XCthulhudj/BALANCE_CAR/Doc/PCB_View.pdf

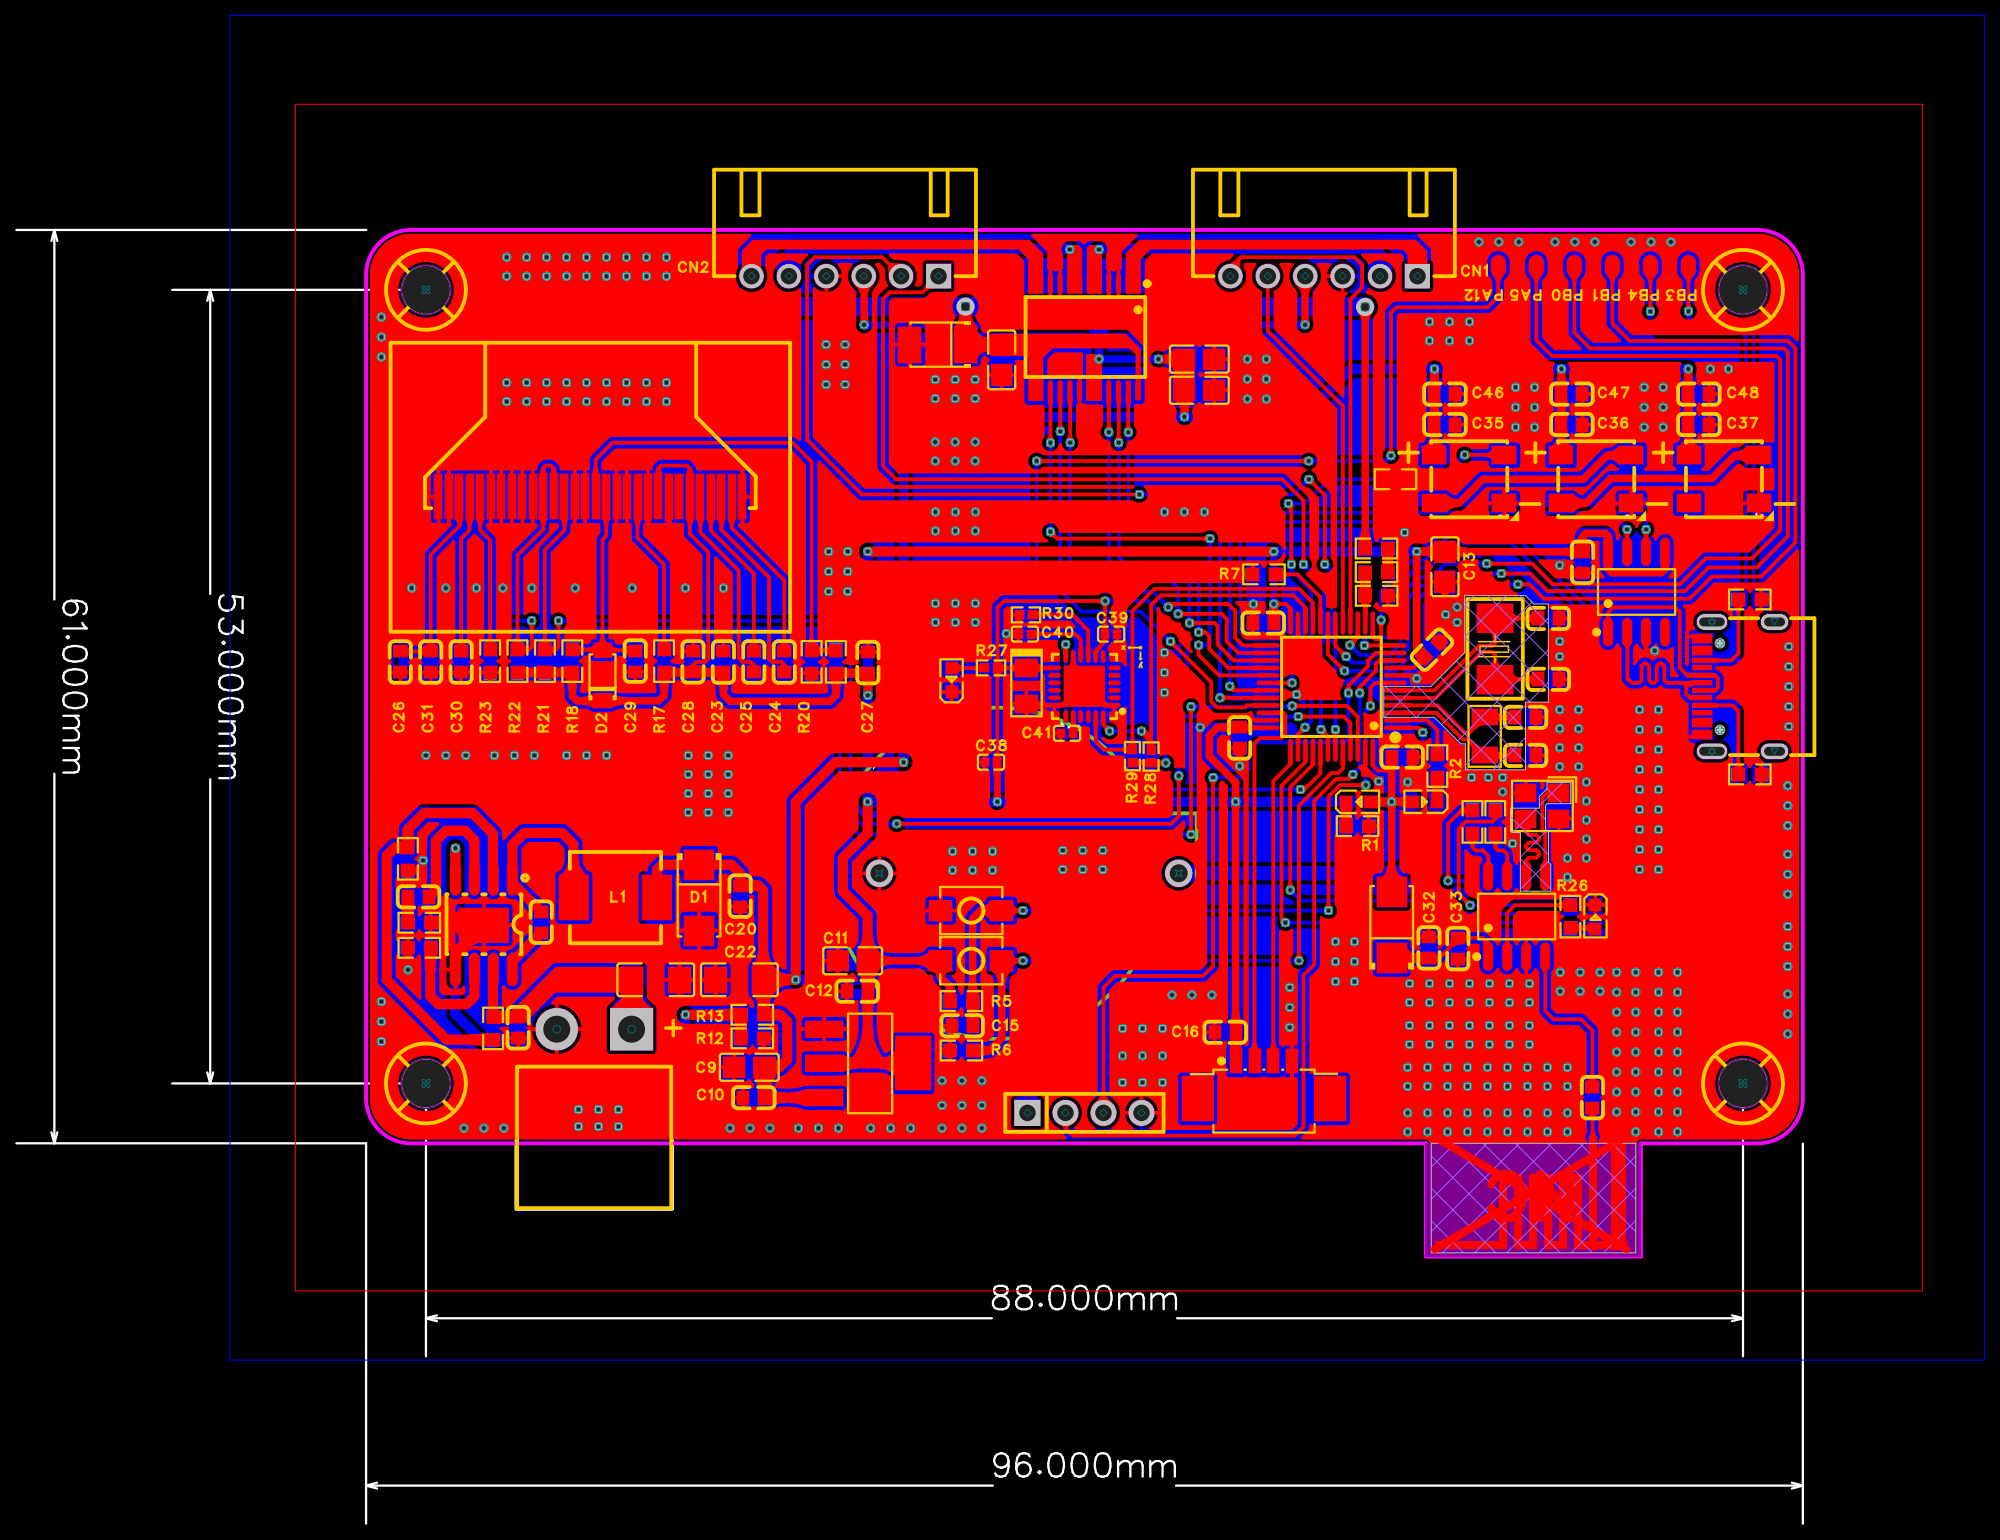
[picture p1: page 1]

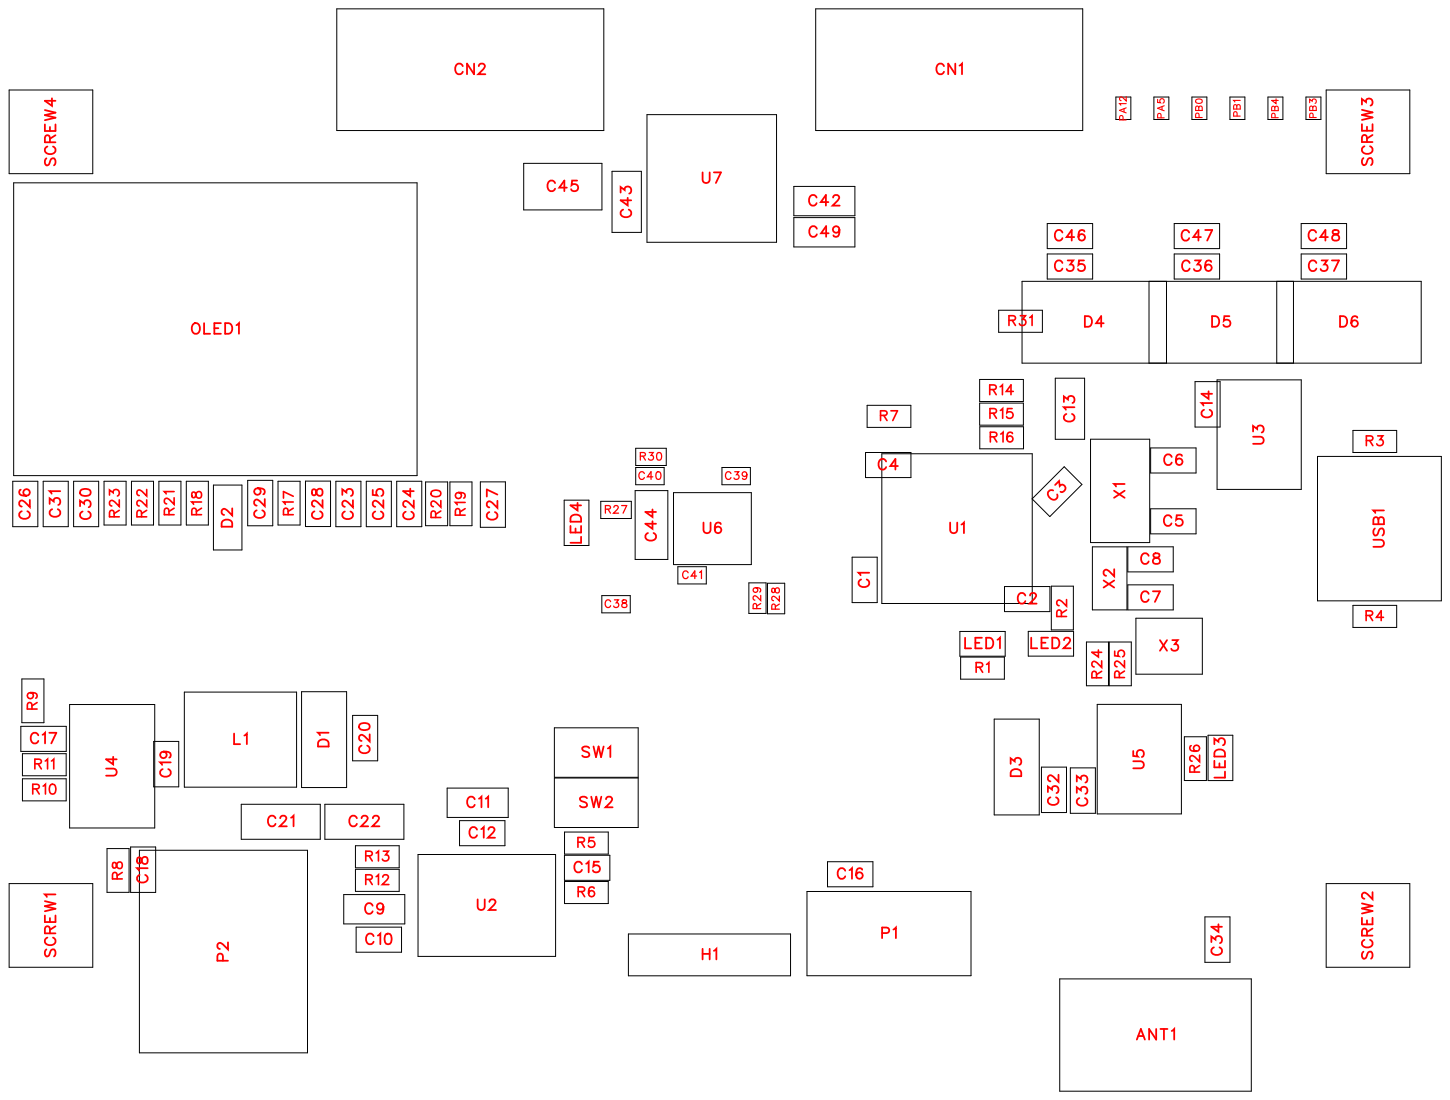
[picture p2: page 2]

BAT1

No. | Quantity | Comment | Designator | Footprint | Value | Manufacturer Part | Manufacturer | Supplier Part | Supplier
1 | 1 | KH-BS2032-2-1 | BAT1 | BAT-TH_KH-BS2032-2-1 | | KH-BS2032-2-1 | kinghelm(金 航标) | C3038670 | LCSC
2 | 16 | 100nF | C1,C2,C3,C4,C10,C12,C14, C15,C16,C18,C19,C20,C33 ,C35,C36,C37 | C0603 | 100nF
3 | 4 | 22pF | C5,C6,C7,C8 | C0603 | 22pF
4 | 4 | 10uF | C9,C11,C13,C49 | C0805 | 10uF
5 | 1 | 100pF | C17 | C0603 | 100pF
6 | 2 | 10uF | C21,C22 | C1206 | 10uF
7 | 5 | 1uF | C23,C24,C25,C26,C27 | C0603 | 1uF
8 | 4 | 2.2uF | C28,C29,C30,C31 | C0603 | 2.2uF
9 | 4 | 10uF | C32,C46,C47,C48 | C0603 | 10uF
10 | 1 | 2.7pF | C34 | C0603 | 2.7pF
11 | 1 | 10uF | C38 | C0402 | 10uF
12 | 1 | 10nF | C39 | C0402 | 10nF
13 | 1 | 100nF | C40 | C0402 | 100nF
14 | 1 | 2.2nF | C41 | C0402 | 2.2nF
15 | 2 | 100nF | C42,C43 | C0805 | 100nF
16 | 1 | 3216A-0.1uF/ 4V | C44 | CAP-SMD_L 3.2-W1.6-FD | | 3216A-0.1uF/ 4V | | C990000143 2 | LCSC
17 | 1 | 10uF | C45 | CASE-B_352 8 | 10uF | CA45-B-25V-10uF-K | CEC(振华新 云) | C128259 | LCSC
18 | 2 | X8821WR-06 S-N0SN | CN1,CN2 | CONN-TH_6 P-P2.50_X88 21WR-06S-N 2SN | | X8821WR-06 S-N0SN | XKB Connect ion(中国星坤) | C388743 | LCSC
19 | 1 | SS34 | D1 | SMA_L4.3-W 2.6-LS5.2-R D | | SS34 | MDD(辰达半 导体) | C8678 | LCSC
20 | 1 | 1N4148W-E3 -08 | D2 | SOD-123_L2 .8-W1.8-LS3. 7-RD | | 1N4148W-E3 -08 | VISHAY(威世 ) | C241939 | LCSC
21 | 1 | SS24 | D3 | SMA_L4.3-W 2.6-LS5.2-R D | | SS24 | | C13444 | LCSC
22 | 3 | WS2812 | D4,D5,D6 | LED-SMD_4 P-L5.0-W5.0-TL-A | | WS2812 | worldsemi | C42417498 | LCSC
23 | 1 | HDR-F_2.54 _1x4P | H1 | HDR-TH_4P-P2.54-V-F | | | | C2718488
24 | 1 | 4.7uH | L1 | IND-SMD_L6 .0-W6.0_SLF 6028T | 4.7uH | SLF6028T-4 R7M1R6-PF | TDK | C136198 | LCSC
25 | 1 | PWR | LED1 | LED_0603
26 | 1 | USR | LED2 | LED_0603

27 | 1 | BLE | LED3 | LED_0603
28 | 1 | MPU | LED4 | LED_0603
29 | 1 | X096-2864T MBAG01-H3 0 | OLED1 | OLED-SMD_ X096-2864T MBAG01-H3 0 | | X096-2864T MBAG01-H3 0 | Wisevision( 新智景) | C5123564 | LCSC
30 | 1 | MX1.25-WS-4P | P1 | CONN-SMD_ 4P-P1.25-MX 1.25-4P-WT | | MX1.25-WS-4P | | C990000421 8 | LCSC
31 | 1 | XT30PW-M3 6 | P2 | CONN-TH_2 P-P5.00_XT3 0PW-M36 | | XT30PW-M3 6 | | C990022272 6 | LCSC
32 | 6 | Test-Point | PA5,PA12,PB0,PB1,PB3,P B4 | Test-Point-0. 5mm
33 | 2 | 680 | R1,R2 | R0603 | 680
34 | 2 | 5.1K | R3,R4 | R0603 | 5.1K
35 | 4 | 10K | R5,R6,R7,R16 | R0603 | 10K
36 | 4 | 100K | R8,R9,R10,R11 | R0603 | 100K
37 | 1 | 8.2K | R12 | R0603 | 8.2K
38 | 1 | 43.2K | R13 | R0603 | 43.2K
39 | 2 | 20K | R14,R15 | R0603 | 20K
40 | 6 | 4.7K | R17,R18,R19,R20,R21,R22 | R0603 | 4.7K
41 | 1 | 560K | R23 | R0603 | 560K
42 | 2 | 100 | R24,R25 | R0603 | 100
43 | 1 | 1K | R26 | R0603 | 1K
44 | 1 | 2K | R27 | R0402 | 2K
45 | 2 | 4.7K | R28,R29 | R0402 | 4.7K
46 | 1 | 4.2K | R30 | R0402 | 4.2K
47 | 1 | 330 | R31 | R0603 | 330
48 | 4 | M3螺丝 | SCREW1,SCREW2,SCRE W3,SCREW4 | M3螺丝
49 | 2 | Key_SMD_3 x4x2 | SW1,SW2 | Key_SMD_3 x4x2
50 | 1 | STM32F103 C8T6 | U1 | LQFP-48_L7. 0-W7.0-P0.5 0-LS9.0-BL | | STM32F103 C8T6 | ST(意法半导 体) | C8734 | LCSC
51 | 1 | AMS1117-3. 3 | U2 | SOT-223-3_L 6.5-W3.4-P2. 30-LS7.0-BR | | AMS1117-3. 3 | Advanced Monolithic Systems | C6186 | LCSC
52 | 1 | CH340N | U3 | SOP-8_L4.9-W3.9-P1.27-LS6.0-BL | | CH340N | WCH(南京沁 恒) | C2977777 | LCSC
53 | 1 | MP1584EN | U4 | SOIC-8_L4.9 -W3.9-P1.27-LS6.0-BL-EP 3.3

54 | 1 | KT6368A | U5 | SOP-8_L4.9-W3.9-P1.27-LS6.0-BL | | KT6368A | | C990015550 0 | LCSC
55 | 1 | MPU6050-YJ LTY | U6 | QFN-24_L4.0 -W4.0-P0.50-BL-EP2.7 | | MPU6050-YJ LTY | | C2912107 | LCSC
56 | 1 | TB6612FNG, C,8,EL | U7 | SSOP-24_L8 .3-W5.6-P0.6 5-LS7.6-BL | | TB6612FNG, C,8,EL | TOSHIBA( 东 ) 芝 | C141517 | LCSC
57 | 1 | typec | USB1 | USB-C-SMD _KH-TYPE-C -16P | | typec | | C990001695 6 | LCSC
58 | 1 | 8MHz | X1 | CRYSTAL-S MD_L5.0-W3 .2 | 8MHz | X50328MSB 2GI | YXC(扬兴晶 振) | C115962 | LCSC
59 | 1 | 32.768KHz | X2 | CRYSTAL-S MD_L3.2-W1 .5-1 | | 32.768KHz | | C990001461 8 | LCSC
60 | 1 | 24MHz | X3 | CRYSTAL-S MD_4P-L3.2-W2.5-BL | | 24MHz | | C990001023 3 | LCSC

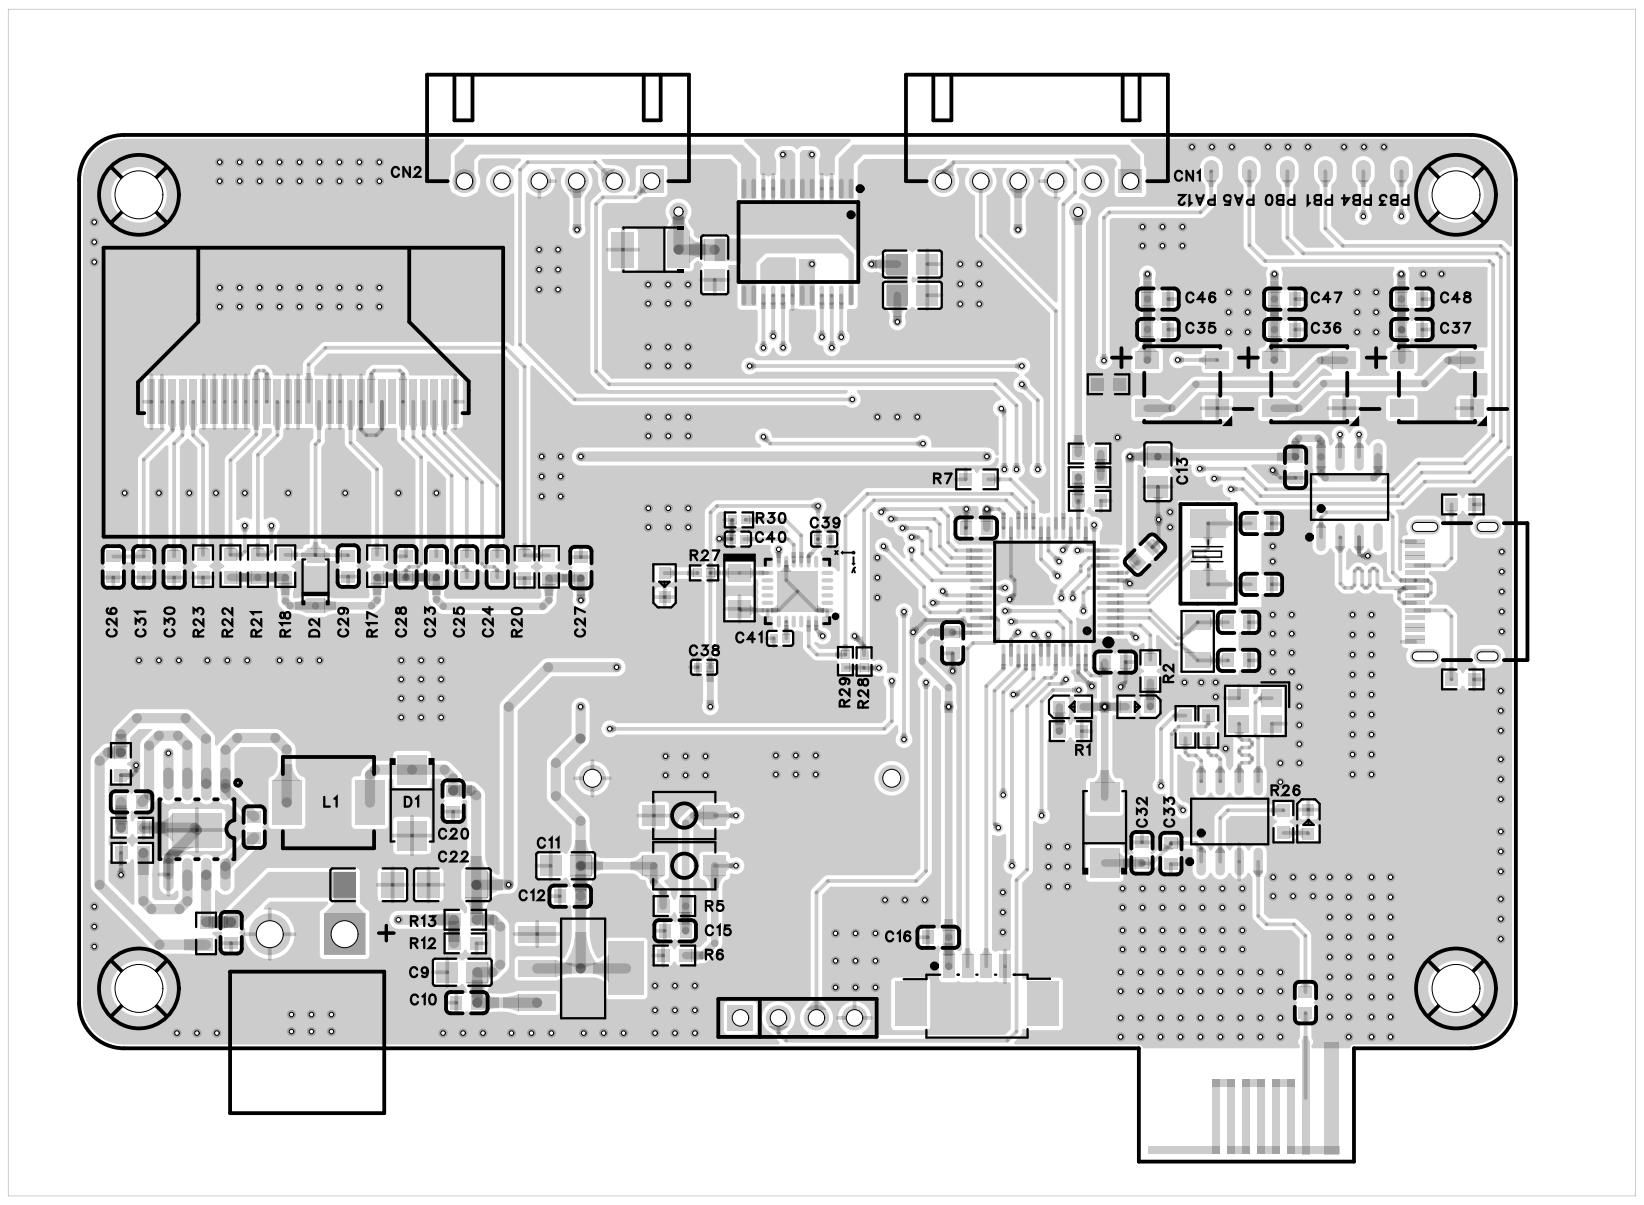
[picture p3: page 7]

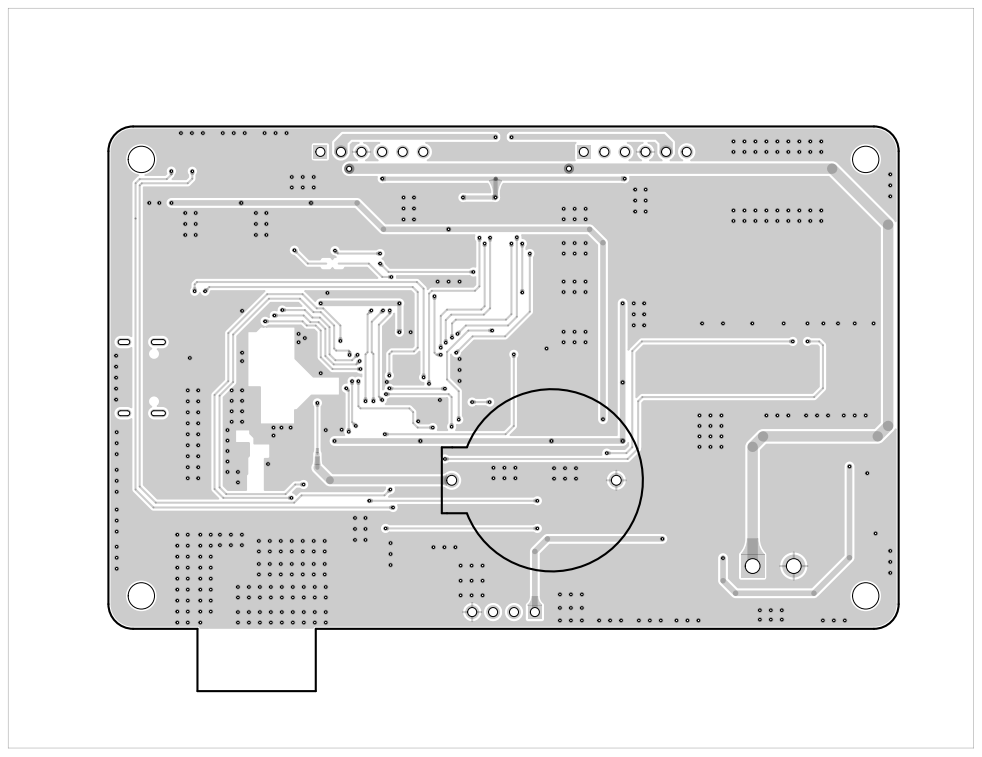
[picture p4: page 8]
