XCthulhudj/BALANCE_CAR/Balance_Car_HAL_Proj.ioc

Mcu.UserName=STM32F103C8Tx
PA0-WKUP.GPIO_Label=SR04_TRIG
PA0-WKUP.Signal=GPIO_Output
PA1.GPIO_Label=SR04_ECHO
PA1.Signal=GPXTI1
PA10.GPIO_Label=USB_RX
PA10.Signal=USART1_RX
PA11.GPIO_Label=PWMA
PA11.Signal=S_TIM1_CH4
PA13.Signal=SYS_JTMS-SWDIO
PA14.Signal=SYS_JTCK-SWCLK
PA2.GPIO_Label=BLE_TX
PA2.Signal=USART2_TX
PA3.GPIO_Label=BLE_RX
PA3.Signal=USART2_RX
PA4.GPIO_Label=ADC_IN
PA4.Signal=ADCx_IN4
PA6.GPIO_Label=M1A
PA6.Signal=S_TIM3_CH1
PA7.GPIO_Label=M1B
PA7.Signal=S_TIM3_CH2
PA8.GPIO_Label=PWMB
PA8.Signal=S_TIM1_CH1
PA9.GPIO_Label=USB_TX
PA9.Signal=USART1_TX
PB10.GPIO_Label=MPU6050_SCL
PB10.Signal=I2C2_SCL
PB11.GPIO_Label=MPU6050_SDA
PB11.Signal=I2C2_SDA
PB12.GPIO_Label=BIN2
PB12.Signal=GPIO_Output
PB13.GPIO_Label=BIN1
PB13.Signal=GPIO_Output
PB14.GPIO_Label=AIN1
PB14.Signal=GPIO_Output
PB15.GPIO_Label=AIN2
PB15.Signal=GPIO_Output
PB5.GPIO_Label=MPU6050_INT
PB5.Signal=GPXTI5
PB6.GPIO_Label=M2A
PB6.Signal=S_TIM4_CH1
PB7.GPIO_Label=M2B
PB7.Signal=S_TIM4_CH2
PB8.GPIO_Label=OLED_SCL
PB8.Signal=I2C1_SCL
PB9.GPIO_Label=OLED_SDA
PB9.Signal=I2C1_SDA
PC13-TAMPER-RTC.GPIO_Label=LED
PC13-TAMPER-RTC.Signal=GPIO_Output
PD0-OSC_IN.Signal=RCC_OSC_IN
PD1-OSC_OUT.Signal=RCC_OSC_OUT
