XCthulhudj/BALANCE_CAR/Core/Inc/main.h

#define LED_Pin GPIO_PIN_13
#define LED_GPIO_Port GPIOC
#define SR04_TRIG_Pin GPIO_PIN_0
#define SR04_TRIG_GPIO_Port GPIOA
#define SR04_ECHO_Pin GPIO_PIN_1
#define SR04_ECHO_GPIO_Port GPIOA
#define SR04_ECHO_EXTI_IRQn EXTI1_IRQn
#define BLE_TX_Pin GPIO_PIN_2
#define BLE_TX_GPIO_Port GPIOA
#define BLE_RX_Pin GPIO_PIN_3
#define BLE_RX_GPIO_Port GPIOA
#define ADC_IN_Pin GPIO_PIN_4
#define ADC_IN_GPIO_Port GPIOA
#define M1A_Pin GPIO_PIN_6
#define M1A_GPIO_Port GPIOA
#define M1B_Pin GPIO_PIN_7
#define M1B_GPIO_Port GPIOA
#define MPU6050_SCL_Pin GPIO_PIN_10
#define MPU6050_SCL_GPIO_Port GPIOB
#define MPU6050_SDA_Pin GPIO_PIN_11
#define MPU6050_SDA_GPIO_Port GPIOB
#define BIN2_Pin GPIO_PIN_12
#define BIN2_GPIO_Port GPIOB
#define BIN1_Pin GPIO_PIN_13
#define BIN1_GPIO_Port GPIOB
#define AIN1_Pin GPIO_PIN_14
#define AIN1_GPIO_Port GPIOB
#define AIN2_Pin GPIO_PIN_15
#define AIN2_GPIO_Port GPIOB
#define PWMB_Pin GPIO_PIN_8
#define PWMB_GPIO_Port GPIOA
#define USB_TX_Pin GPIO_PIN_9
#define USB_TX_GPIO_Port GPIOA
#define USB_RX_Pin GPIO_PIN_10
#define USB_RX_GPIO_Port GPIOA
#define PWMA_Pin GPIO_PIN_11
#define PWMA_GPIO_Port GPIOA
#define MPU6050_INT_Pin GPIO_PIN_5
#define MPU6050_INT_GPIO_Port GPIOB
#define MPU6050_INT_EXTI_IRQn EXTI9_5_IRQn
#define M2A_Pin GPIO_PIN_6
#define M2A_GPIO_Port GPIOB
#define M2B_Pin GPIO_PIN_7
#define M2B_GPIO_Port GPIOB
#define OLED_SCL_Pin GPIO_PIN_8
#define OLED_SCL_GPIO_Port GPIOB
#define OLED_SDA_Pin GPIO_PIN_9
#define OLED_SDA_GPIO_Port GPIOB
