XCthulhudj/BALANCE_CAR/(commit log)

2026-09-25 Modified the serial port. Changed to DMA circular transmission.
2026-09-25 Improved OLED driver based on serial port
2026-09-27 Added the mpu6050 driver
2026-09-28 Completed RC, MPU6050, and DEBUG module, but DMP have problems
    [app_config.h, app_debug.c, app_debug.h, bsp_i2c.c, bsp_i2c.h, bsp_it.c, bsp_uart.c, bsp_uart.h]
2026-10-01 The 5V network had problem. The WS2812 and TB6612 had short-circuited and been damaged. The project lacked the motor speed correction and PID parameters.
    [Balance_Car_HAL_Proj.ioc, app_debug.c, bsp_i2c.c, bsp_i2c.h, bsp_it.c, bsp_it.h, hc_sr04.c]
2026-10-03 PID parameters are still missing and have not been debugged.
    [Balance_Car_HAL_Proj.ioc, app_debug.c, app_debug.h, attitude.c, bsp_uart.c, bsp_uart.h]
2026-10-04 It's better to use 6V motor not 12V
2026-10-18 Adjusted the PID value and added the PCB pdf file
2026-10-19 Adjusted the PID value and added the simulation file
